CircuitCo/BeagleBone-CANBus-RevA2/BeagleBone-CANBus-RevA2-bom.xlsx

BEAGLEBONE CANBUS REV A2
BILL OF MATERIALS
ITM | QTY | REF DESIGNATORS | PART | PCB FOOTPRINT | DESCRIPTION | MAN | PART NUMBER | COMMENT
1 | 2 | C1,C2 | 100pF | SM-7351-CAP-0402 | CAP CER 100PF 50V 5% C0G 0402 | DK | CC0402JRNP09BN101
2 | 5 | C3,C19,C21,C17 | 0.1uF | SM-7351-CAP-0402 | CAPACITOR 0.1uF 16V 10% 0402 X7R | KEMMET | C0402C104K4RACT
3 | 1 | C4 | 0.01uF | SM-7351-CAP-0402 | CAPACITOR 0.01uF 16V 10% 0402 | PANASONIC | ECJ-0YB1C103K
4 | 1 | C5 | 4.7uF | SM-7351-CAP-0603 | CAP CER 4.7uF 6.3V X5R 0603 | MURATA | GRM188R60J475ME19D
5 | 2 | C18,C20 | 10uF | SM-7351-CAP-0805 | CAP CER 10UF 10V Y5V 0805 | TDK | C2012Y5V1A106Z
6 | 1 | C23 | 3.3uF | SM-7351-CAP-0603 | CAP 3.3uF 10V 10% 0603 X5R | TDK | C1608X5R1A335
7 | 1 | D3 | 598-8170-107F | LED0805-1 | LED GREEN SMD 20mA 2V 0805 | DIALIGHT | 598-8170-107F
8 | 1 | J1 | CONN_DB9F | NorComp_db9F_SMD | CONN DB9 FEMALE R/A SOLDER SMD | NORCOMP | 190-009-263R001
9 | 2 | P1,P2 | 2x23 HEADER FEMALE | HEADER23X2 | .100 CL DUAL ROW - STRAIGHT SOCKET STRIP - USING .025" SQ. PINS | MLE | SSHQ-123-D-08-G-LF
 |  |  | 2x23 HEADER FEMALE | HEADER23X2 | .100 CL DUAL ROW - STRAIGHT SOCKET STRIP - USING .025" SQ. PINS | MLE | SSHQ-123-D-08-F-LF
10 | 1 | P3 | 2x5 HEADER FEMALE | HEADER5X2 | .100 CL DUAL ROW - STRAIGHT SOCKET STRIP - USING .025" SQ. PINS | MLE | SSHQ-105-D-08-G-LF
 |  |  | 2x5 HEADER FEMALE | HEADER5X2 | .100 CL DUAL ROW - STRAIGHT SOCKET STRIP - USING .025" SQ. PINS | MLE | SSHQ-105-D-08-F-LF
11 | 2 | R1,R2 | 33 | SM-7351-RES-0402 | RES 33.0 OHM 1/16W 1% 0402 SMD | YAEGO | RC0402FR-0733RL
12 | 2 | R6,R7 | 5.6K,5% | 402 | RES 5.6K OHM 1/16W 5% 0402 SMD | YAEGO | RC0402JR-075K6L
13 | 3 | R8,R9,R10 | 4.75K | 402 | RES 4.75K OHM 1/16W 1% 0402 SMD | STACKPOLE | RMCF0402FT4K75
14 | 1 | R11 | 470,5% | 402 | RES 470 OHM 1/10W 5% 0402 SMD | PANASONIC | ERJ-2GEJ471X
15 | 4 | R38,R39,R48,R52 | 0 | SM-7351-RES-0402 | RES 0.0 OHM 1/16W 0402 SMD | DK | RC0402JR-070RL
16 | 1 | R51 | 0 | 603 | RES 0.0 OHM 1/10W 5% 0603 SMD | PANASONIC | ERJ-3GEY0R00V
17 | 1 | R123 | 10K | 402 | RESISTOR 10K OHM 1/16W 5% 0402 | ROHM | MCR01MZPJ103
18 | 1 | SW1 | SW DIP-2 | swdip4_100-339smd | SWITCH TAPE SEAL 2 POS SMD | CTS | 219-2MST
19 | 1 | U1 | ISO1050 | so8_w_dub | IC TXRX CAN 5V 8SOP | DK | ISO1050DUBR
20 | 1 | U5 | CAT24C256W | SOIC_8 | IC EEPROM 256KBIT 400KHZ 8SOIC | ON | CAT24C256WI-G
21 | 1 | U6 | RSZ-3.305HP | rsz | ISOLATED DC TO DC CONVERTER 5V OUT | RECOM | RSZ-3.305HP
 | DNI | R12,R49,R50,J22,J23,J24,J25,J26,J27,J28,J29,U27,C24
