CircuitCo/BeagleBone-CANBus-RevA2/BeagleBone-CANBus-RevA1-schematic.pdf

# 09/27/2012 BBT

# DATE

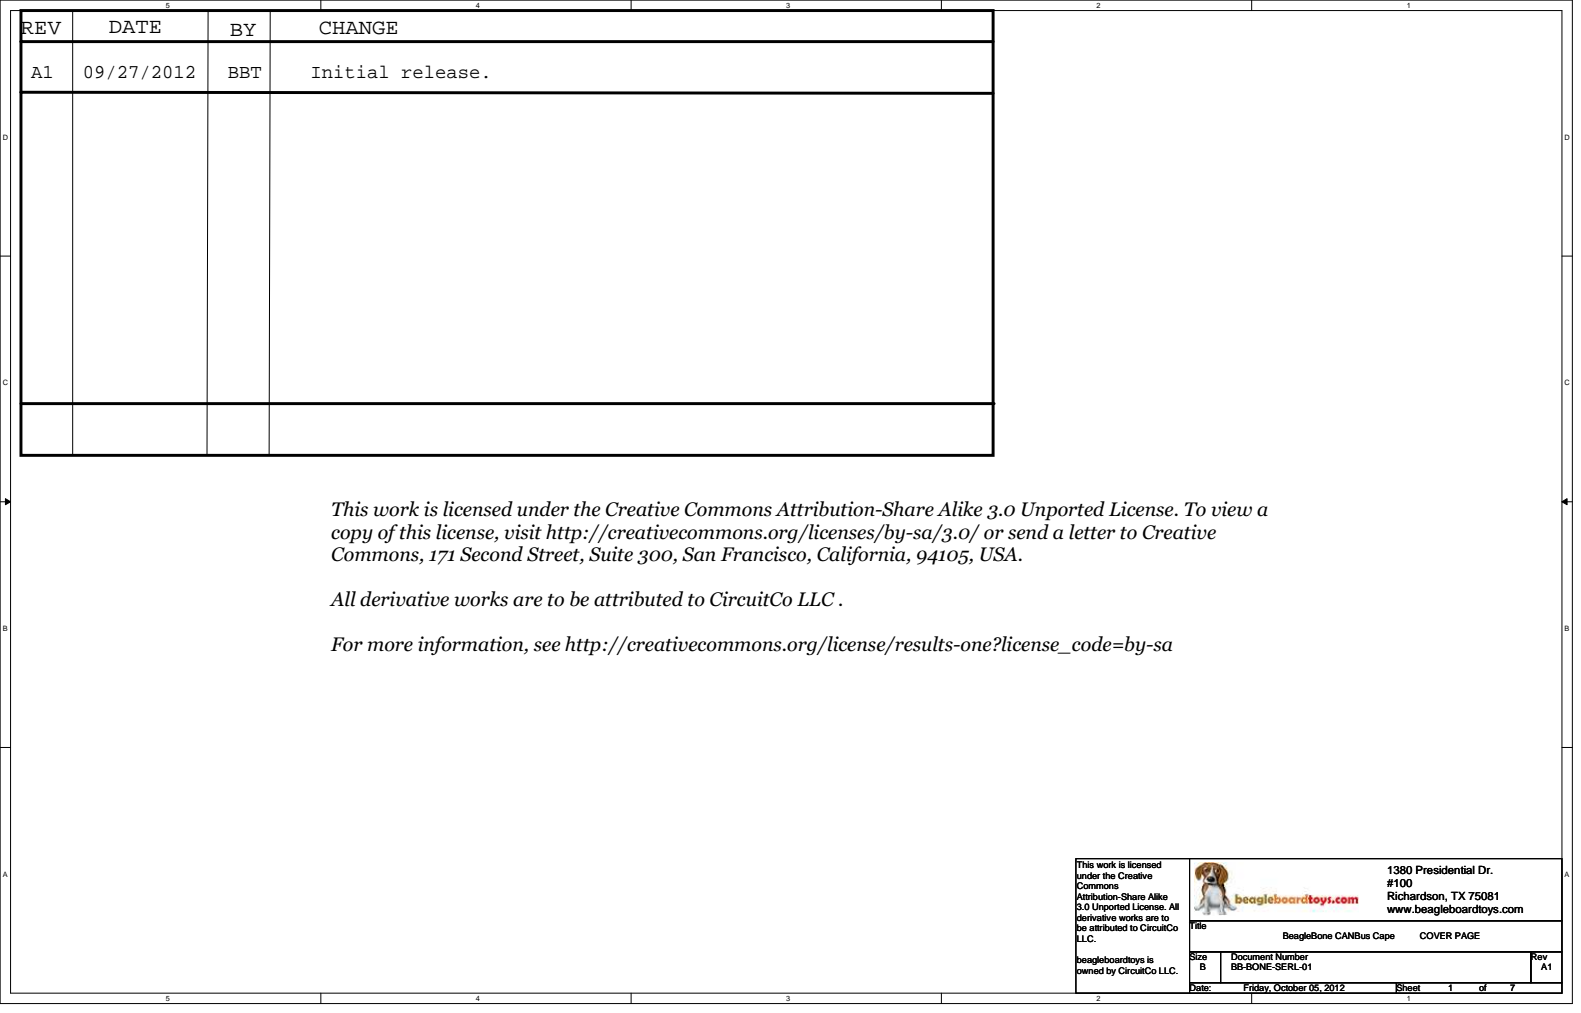
[picture p1: page 1]
REV; CHANGE; Initial release.; Title; Size; Document Number; Rev; Date:; Sheet; BB-BONE-SERL-01; BeagleBone CANBus Cape; COVER PAGE; Friday, October 05, 2012

This work is licensed under the Creative Commons Attribution-Share Alike 3.0 Unported License. To view a
copy of this license, visit http://creativecommons.org/licenses/by-sa/3.0/ or send a letter to Creative
Commons, 171 Second Street, Suite 300, San Francisco, California, 94105, USA.

All derivative works are to be attributed to CircuitCo LLC .

For more information, see http://creativecommons.org/license/results-one?license_code=by-sa

This work is licensed
under the Creative
Commons
Attribution-Share Alike
3.0 Unported License. All
derivative works are to
be attributed to CircuitCo
LLC.

1380 Presidential Dr.
Richardson, TX 75081
www.beagleboardtoys.com

beagleboardtoys is
owned by CircuitCo LLC.

# CANBus

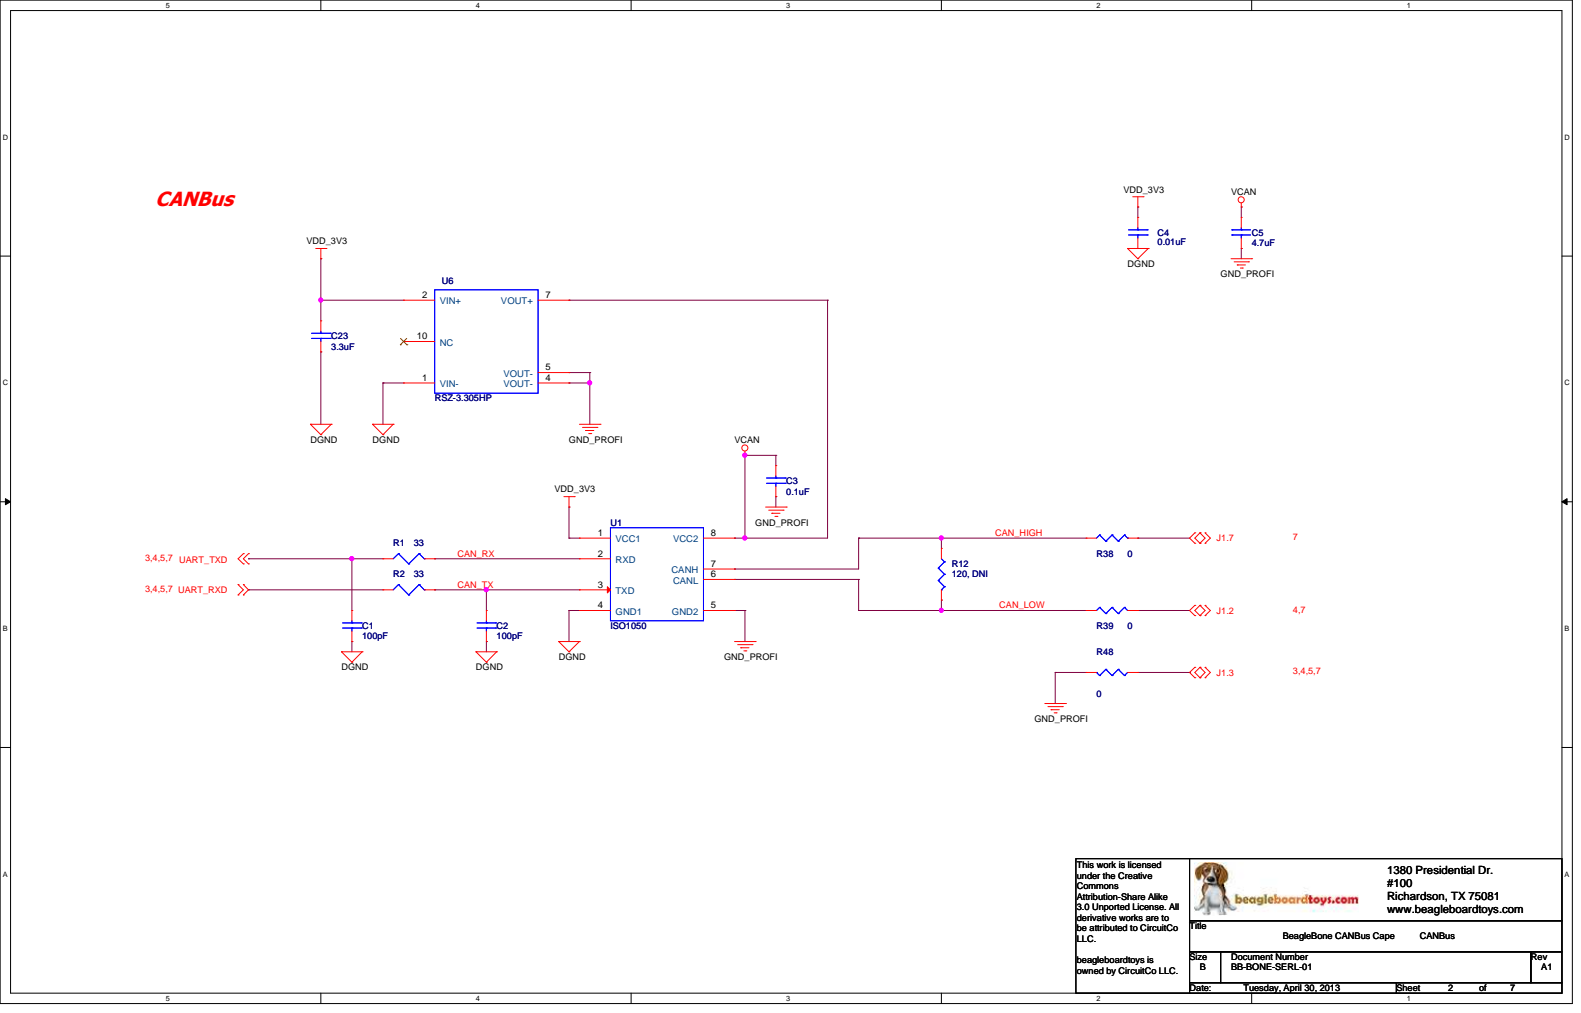
[picture p2: page 2]
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

# ProFiBus

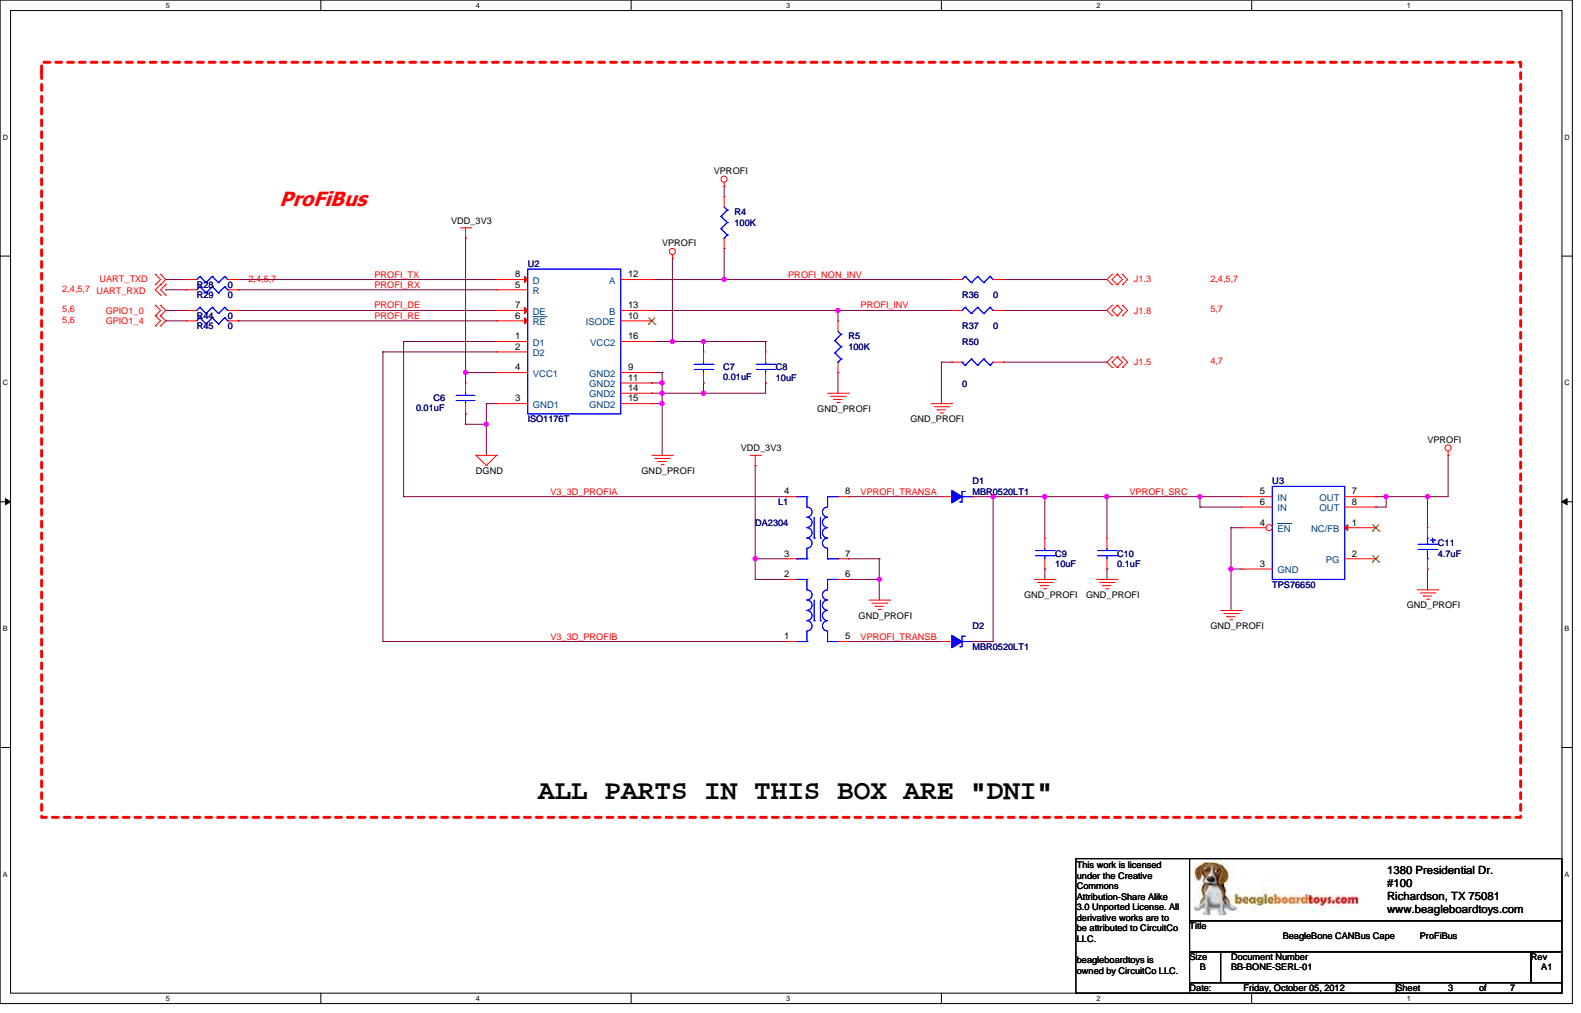
[picture p3: page 3]

ALL PARTS IN THIS BOX ARE "DNI"

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

RS232

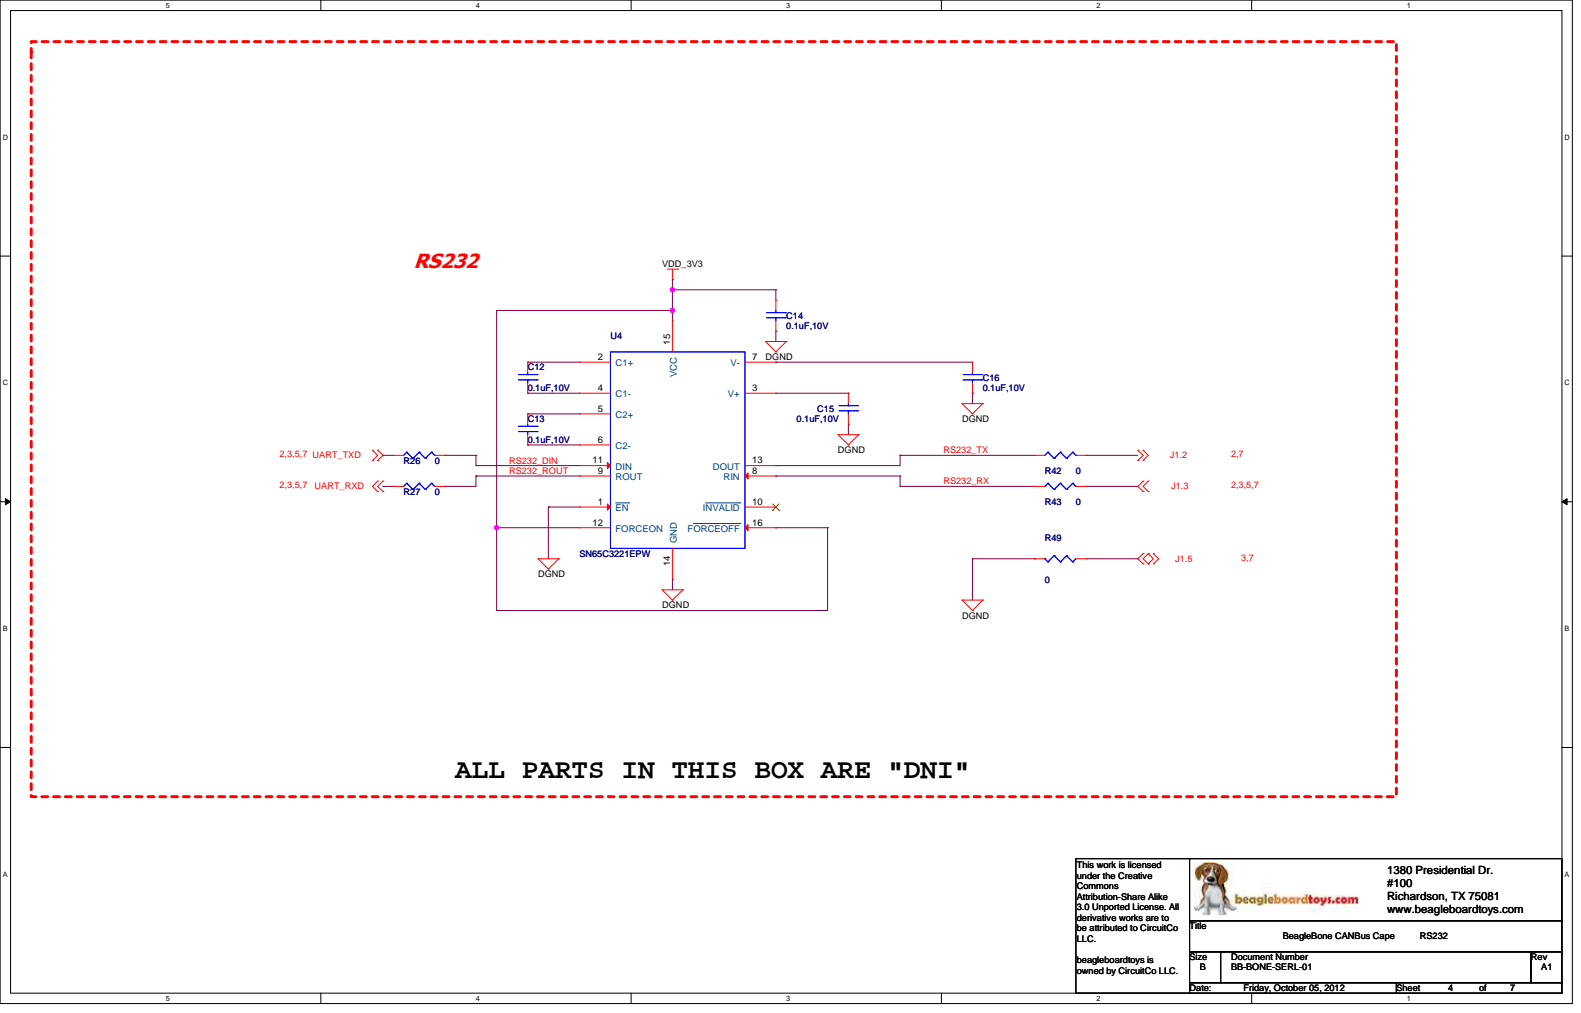
[picture p4: page 4]

ALL PARTS IN THIS BOX ARE "DNI"

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

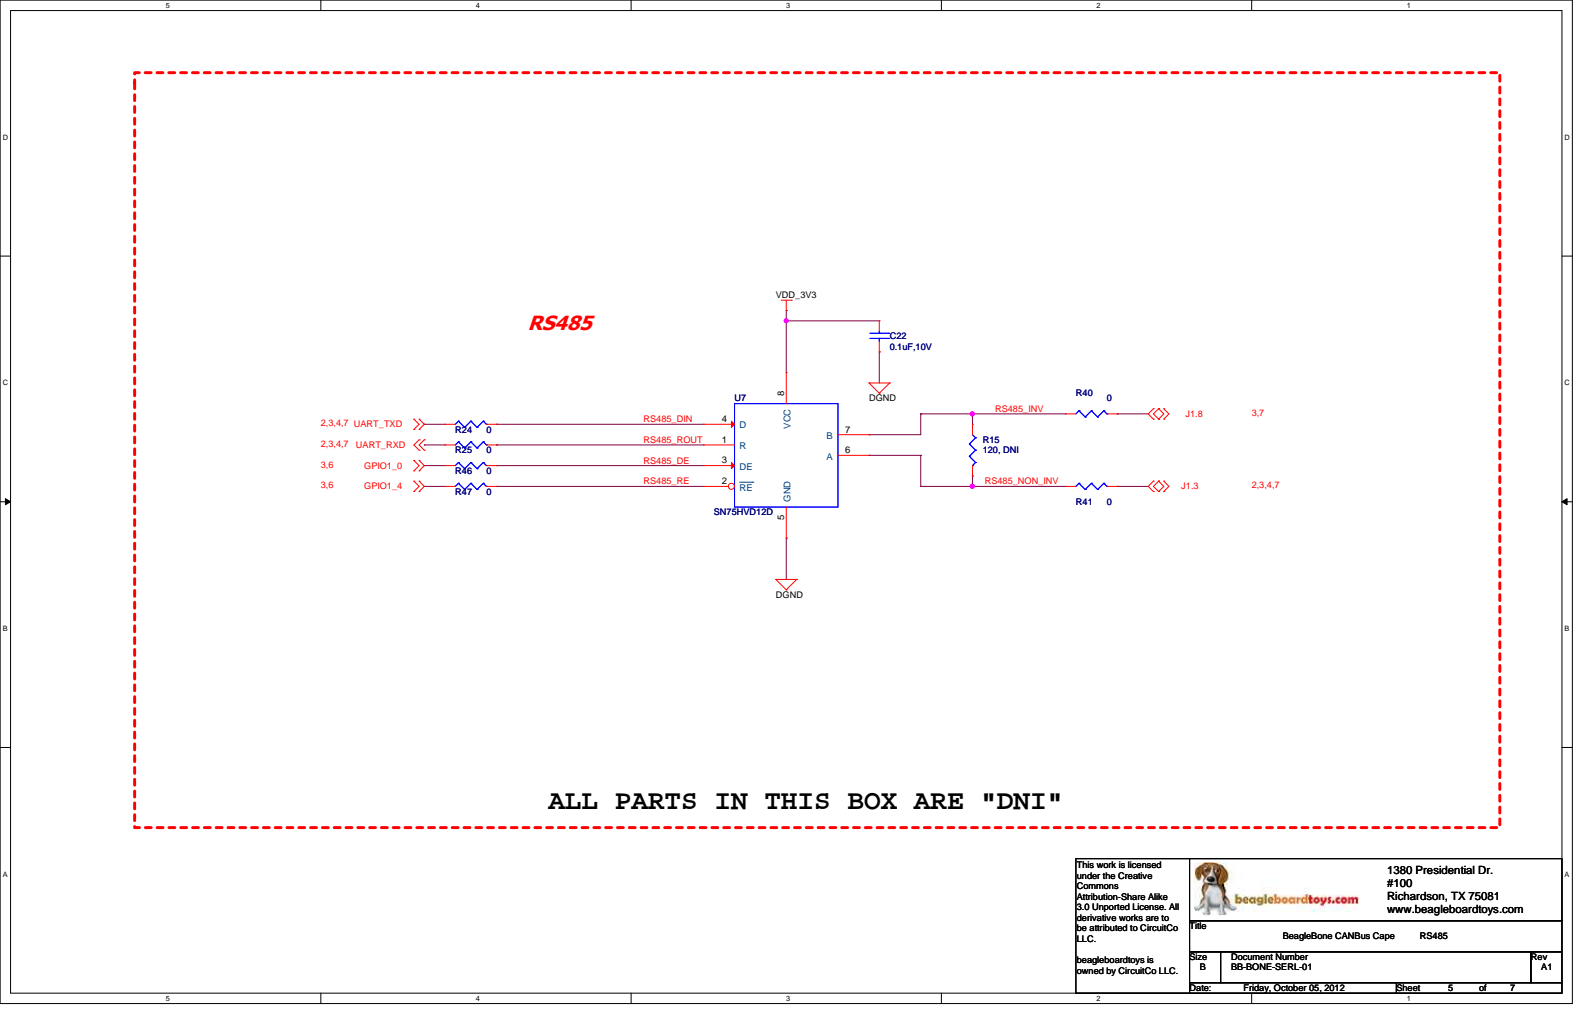
[picture p5: page 5]

ALL PARTS IN THIS BOX ARE "DNI"

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

# Connectors In

# Board ID EEPROM

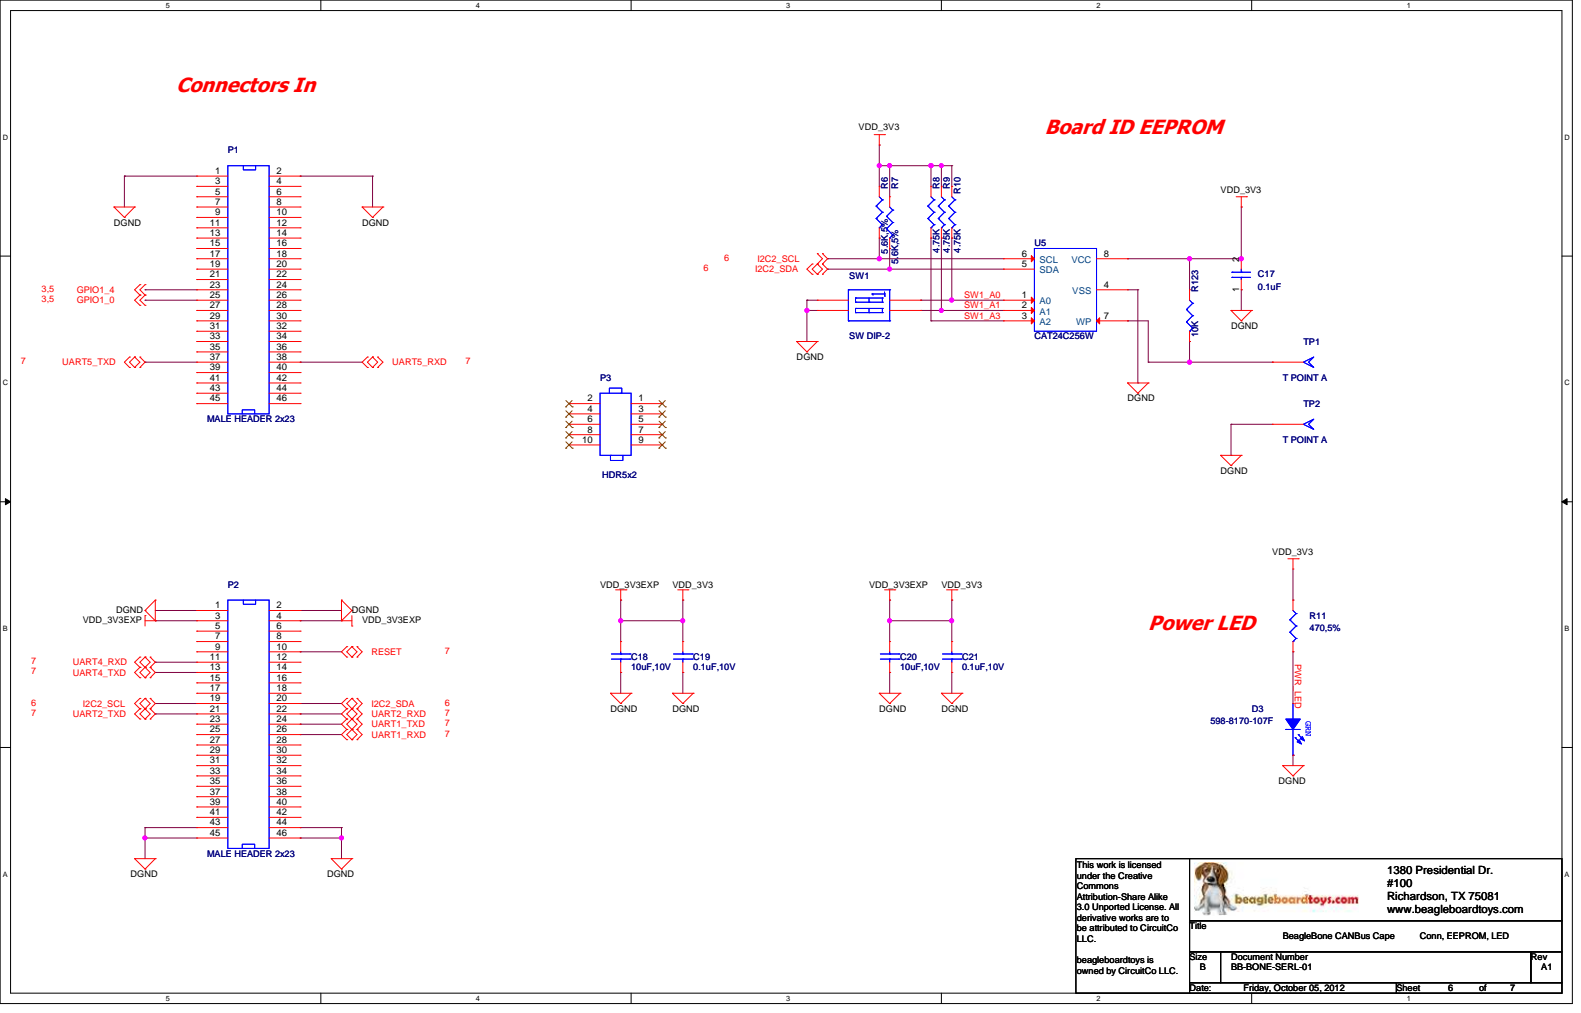
[picture p6: page 6]
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

# Serial Connector

# UART Selection Jumpers

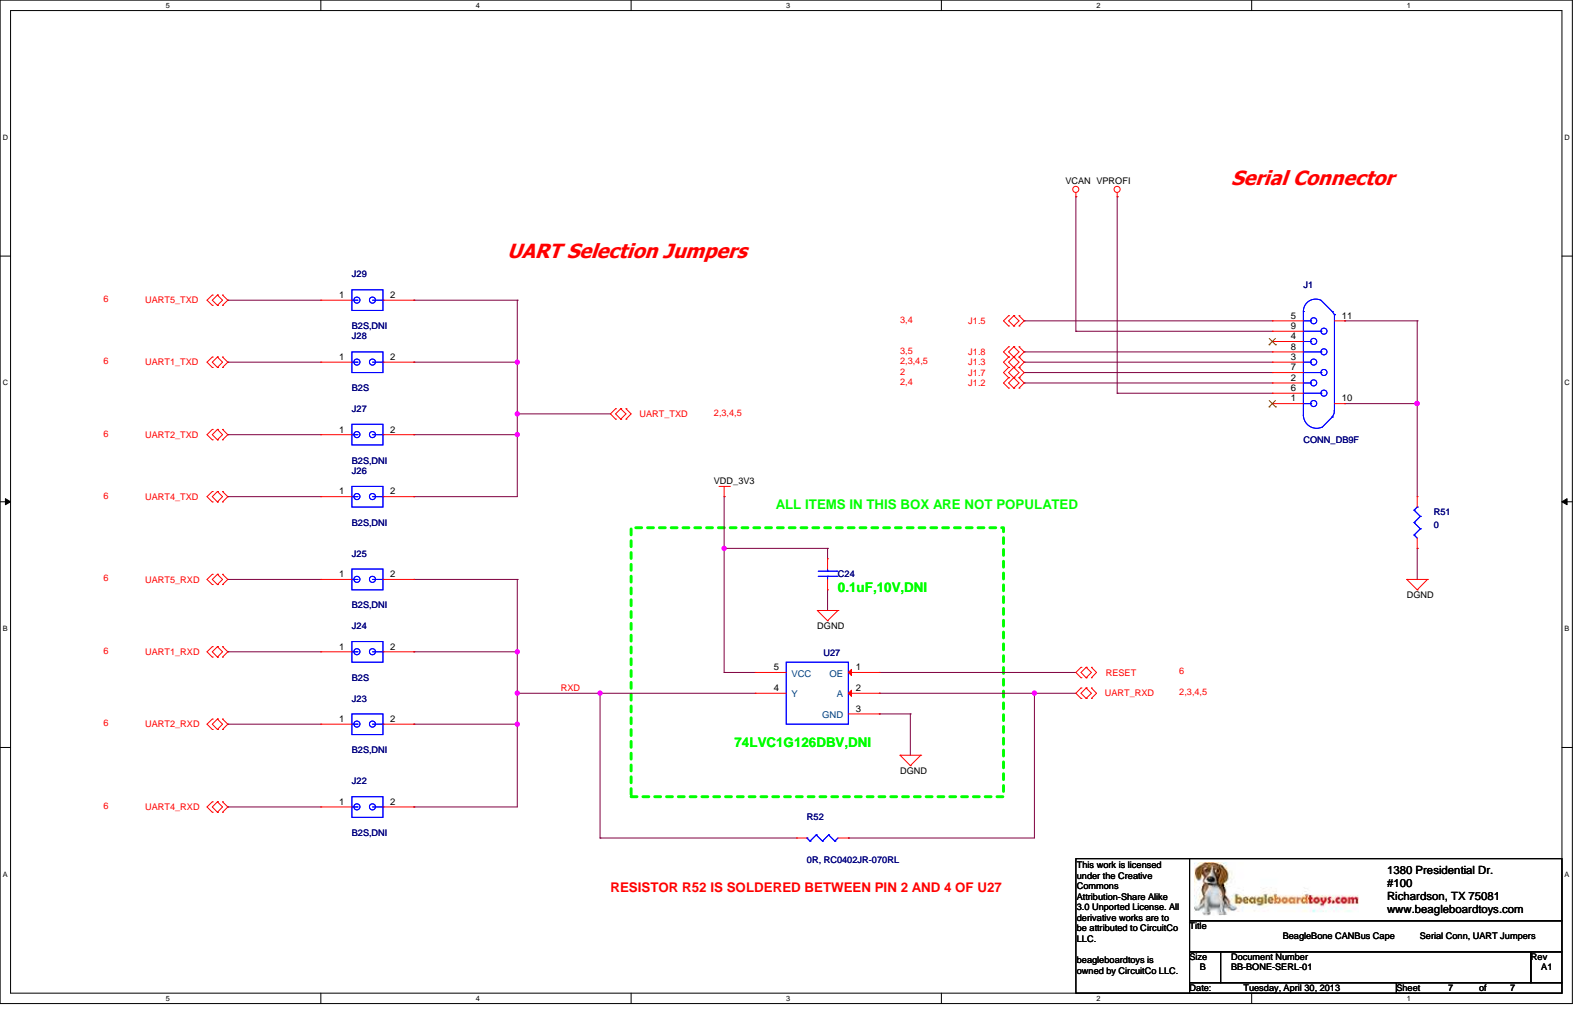
[picture p7: page 7]

ALL ITEMS IN THIS BOX ARE NOT POPULATED

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

RESISTOR R52 IS SOLDERED BETWEEN PIN 2 AND 4 OF U27
