CircuitCo/BeagleBone-CANBus-RevA2/(list of files, drawings)

Other design files:
BeagleBone-CANBus-RevA1-schematic.dsn
